DHasanboy007/Mdiplom/Welcome.md

This is your new *vault*.

Make a note of something, [[create a link]], or try [the Importer](https://help.obsidian.md/Plugins/Importer)!

When you're ready, delete this note and make the vault your own.
