DHasanboy007/Mdiplom/plata/ДИПЛОМ/report.txt

Plotted to 'C:\Users\User\Desktop\UMUMIY\ДИПЛОМ\ДИПЛОМ.pdf'.

Info: Done.
Plotted to 'C:\Users\User\Desktop\UMUMIY\ДИПЛОМ\ДИПЛОМ.pdf'.

Info: Done.
Plotted to 'C:\Users\User\Desktop\ДИПЛОМ.pdf'.

Info: Done.
Plotted to 'C:\Users\User\Desktop\ДИПЛОМ.pdf'.

Info: Done.
Info: Done.
Info: Done.
Info: Done.
Info: Done.
