DHasanboy007/Mdiplom/rasmlar/Rasmlar Anaconda/ieee_488_gpib_clean_schematic.png

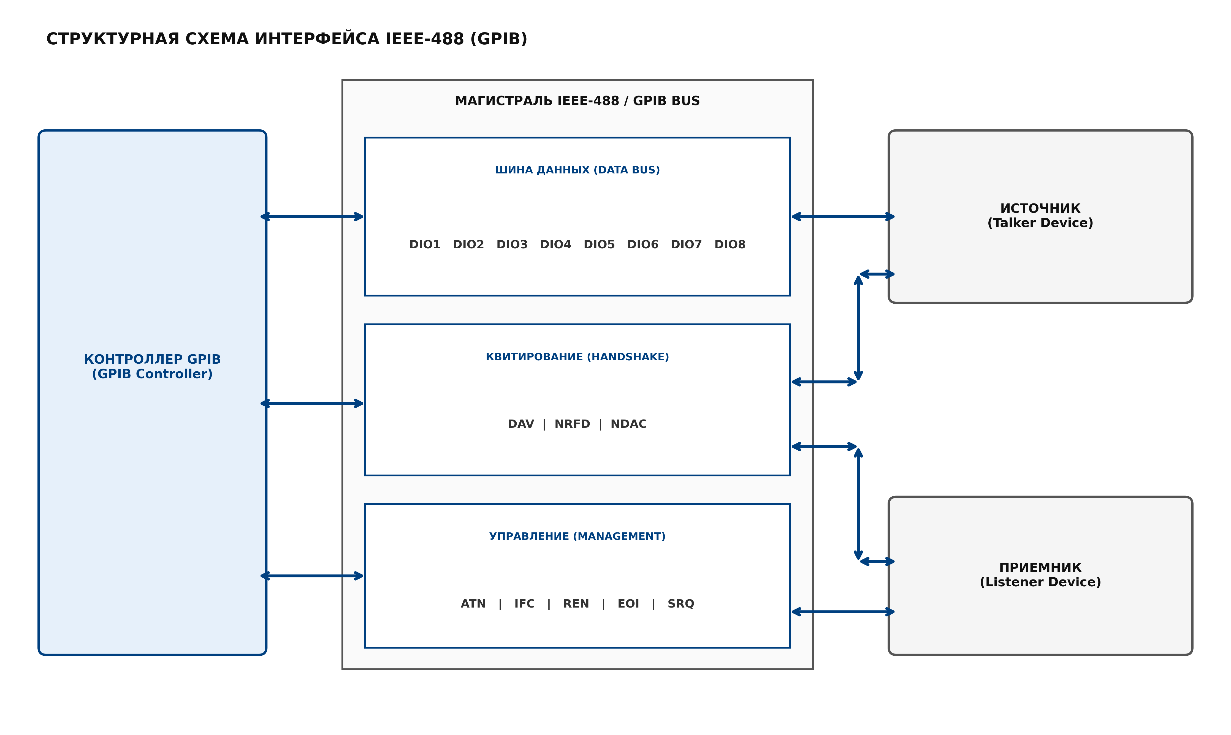
rasmlar/Rasmlar Anaconda/ieee_488_gpib_clean_schematic.png
