DHasanboy007/Mdiplom/rasmlar/Rasmlar Anaconda/ieee_488_gpib_fixed_ru.png

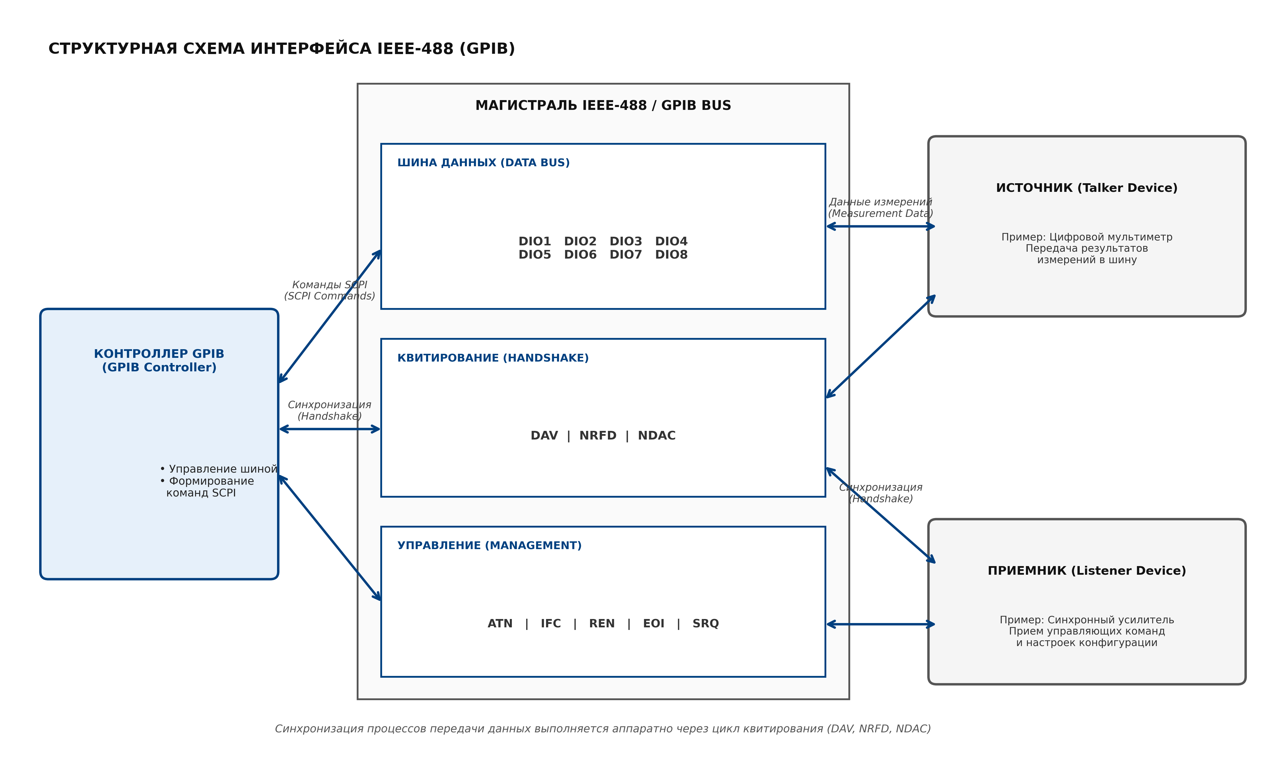
rasmlar/Rasmlar Anaconda/ieee_488_gpib_fixed_ru.png
