DHasanboy007/Mdiplom/rasmlar/Rasmlar Anaconda/ieee_488_gpib_perfect_ru.png

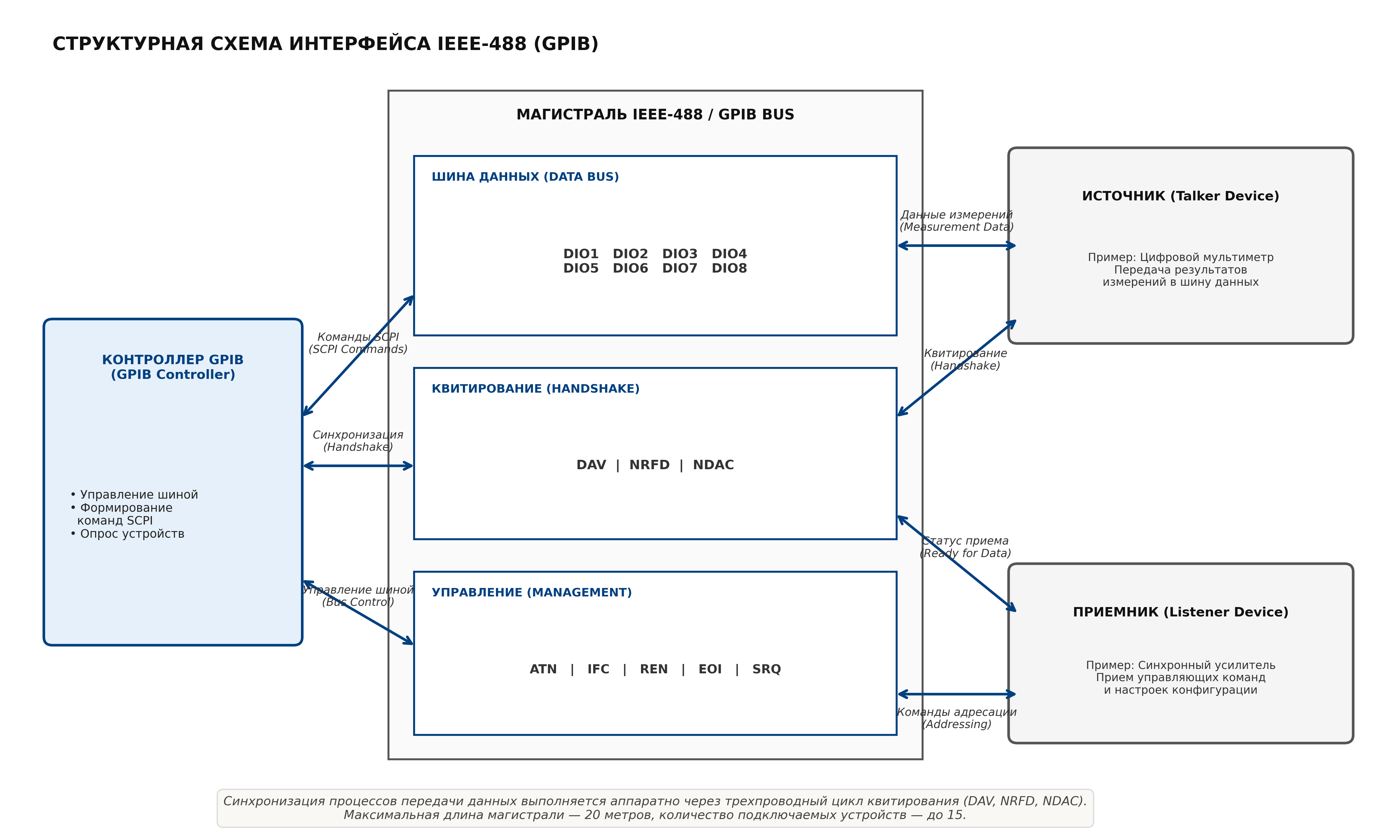
rasmlar/Rasmlar Anaconda/ieee_488_gpib_perfect_ru.png
