DHasanboy007/Mdiplom/rasmlar/Rasmlar Anaconda/structural_diagram.png

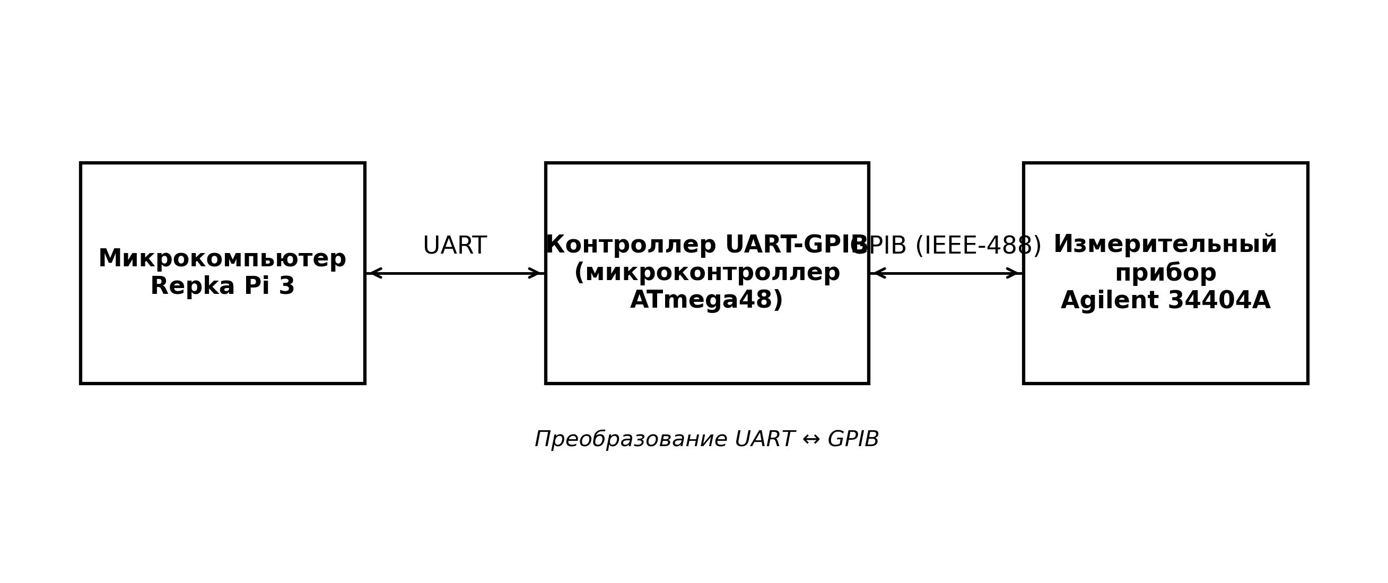
rasmlar/Rasmlar Anaconda/structural_diagram.png
