DHasanboy007/Mdiplom/plata/ДИПЛОМ/ДИПЛОМ.pdf

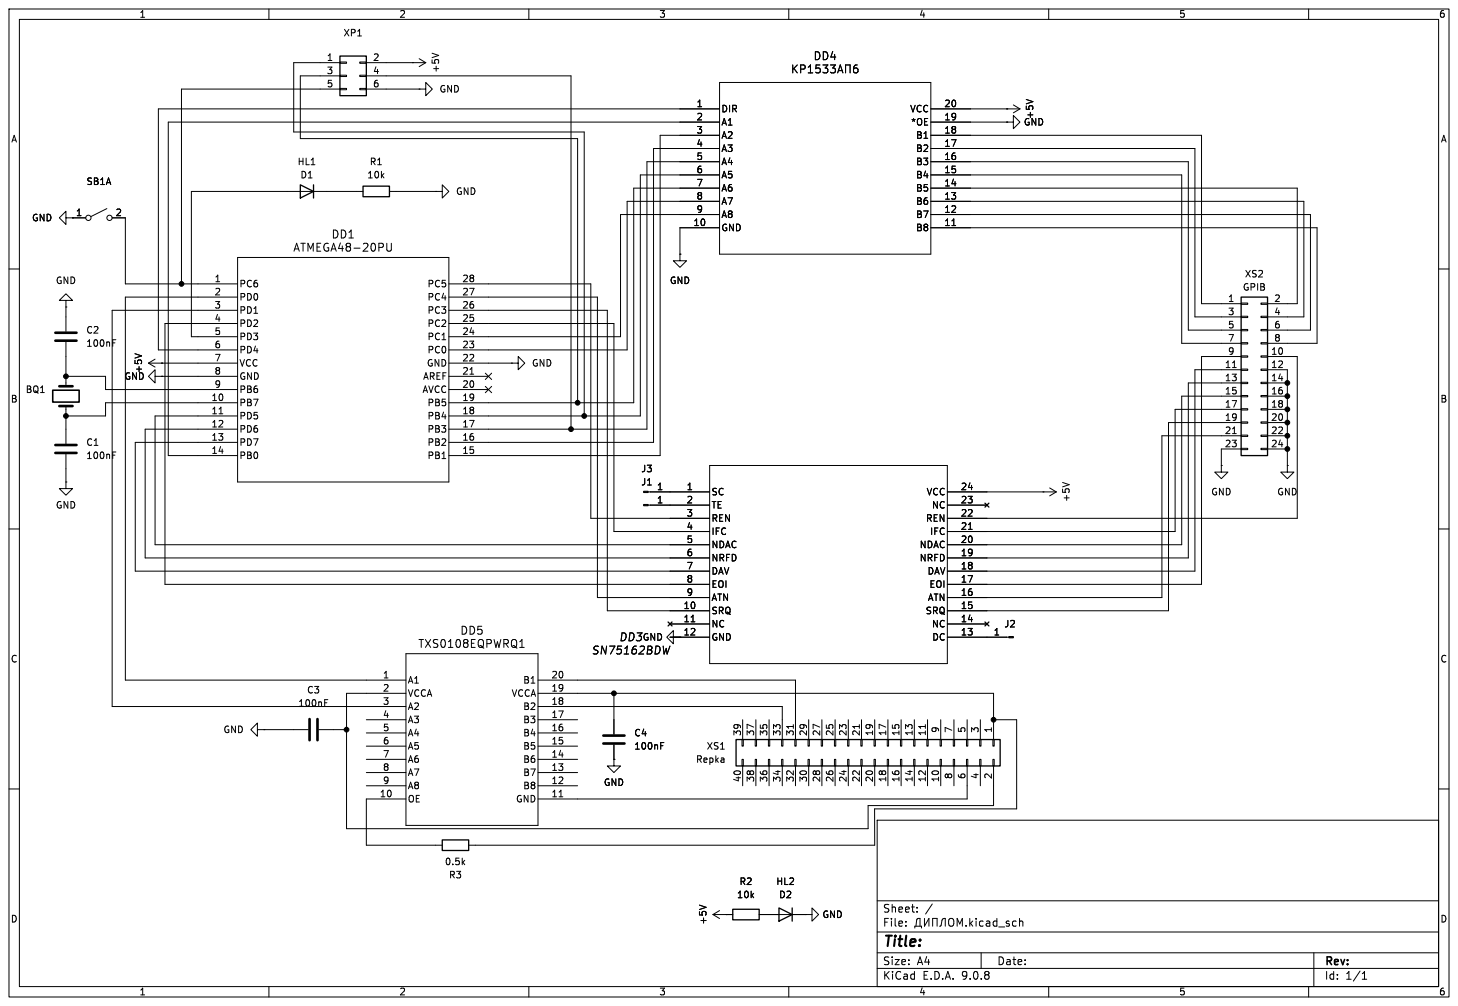
[picture p27: page 1]

Id: 1/1 Title: File: þÿ.kicad_sch Sheet: / R2
