DHasanboy007/Mdiplom/plata/ДИПЛОМ/ДИПЛОМ.kicad_pcb

## KiCad design plata/ДИПЛОМ/ДИПЛОМ.kicad_pcb (2026-06-03)

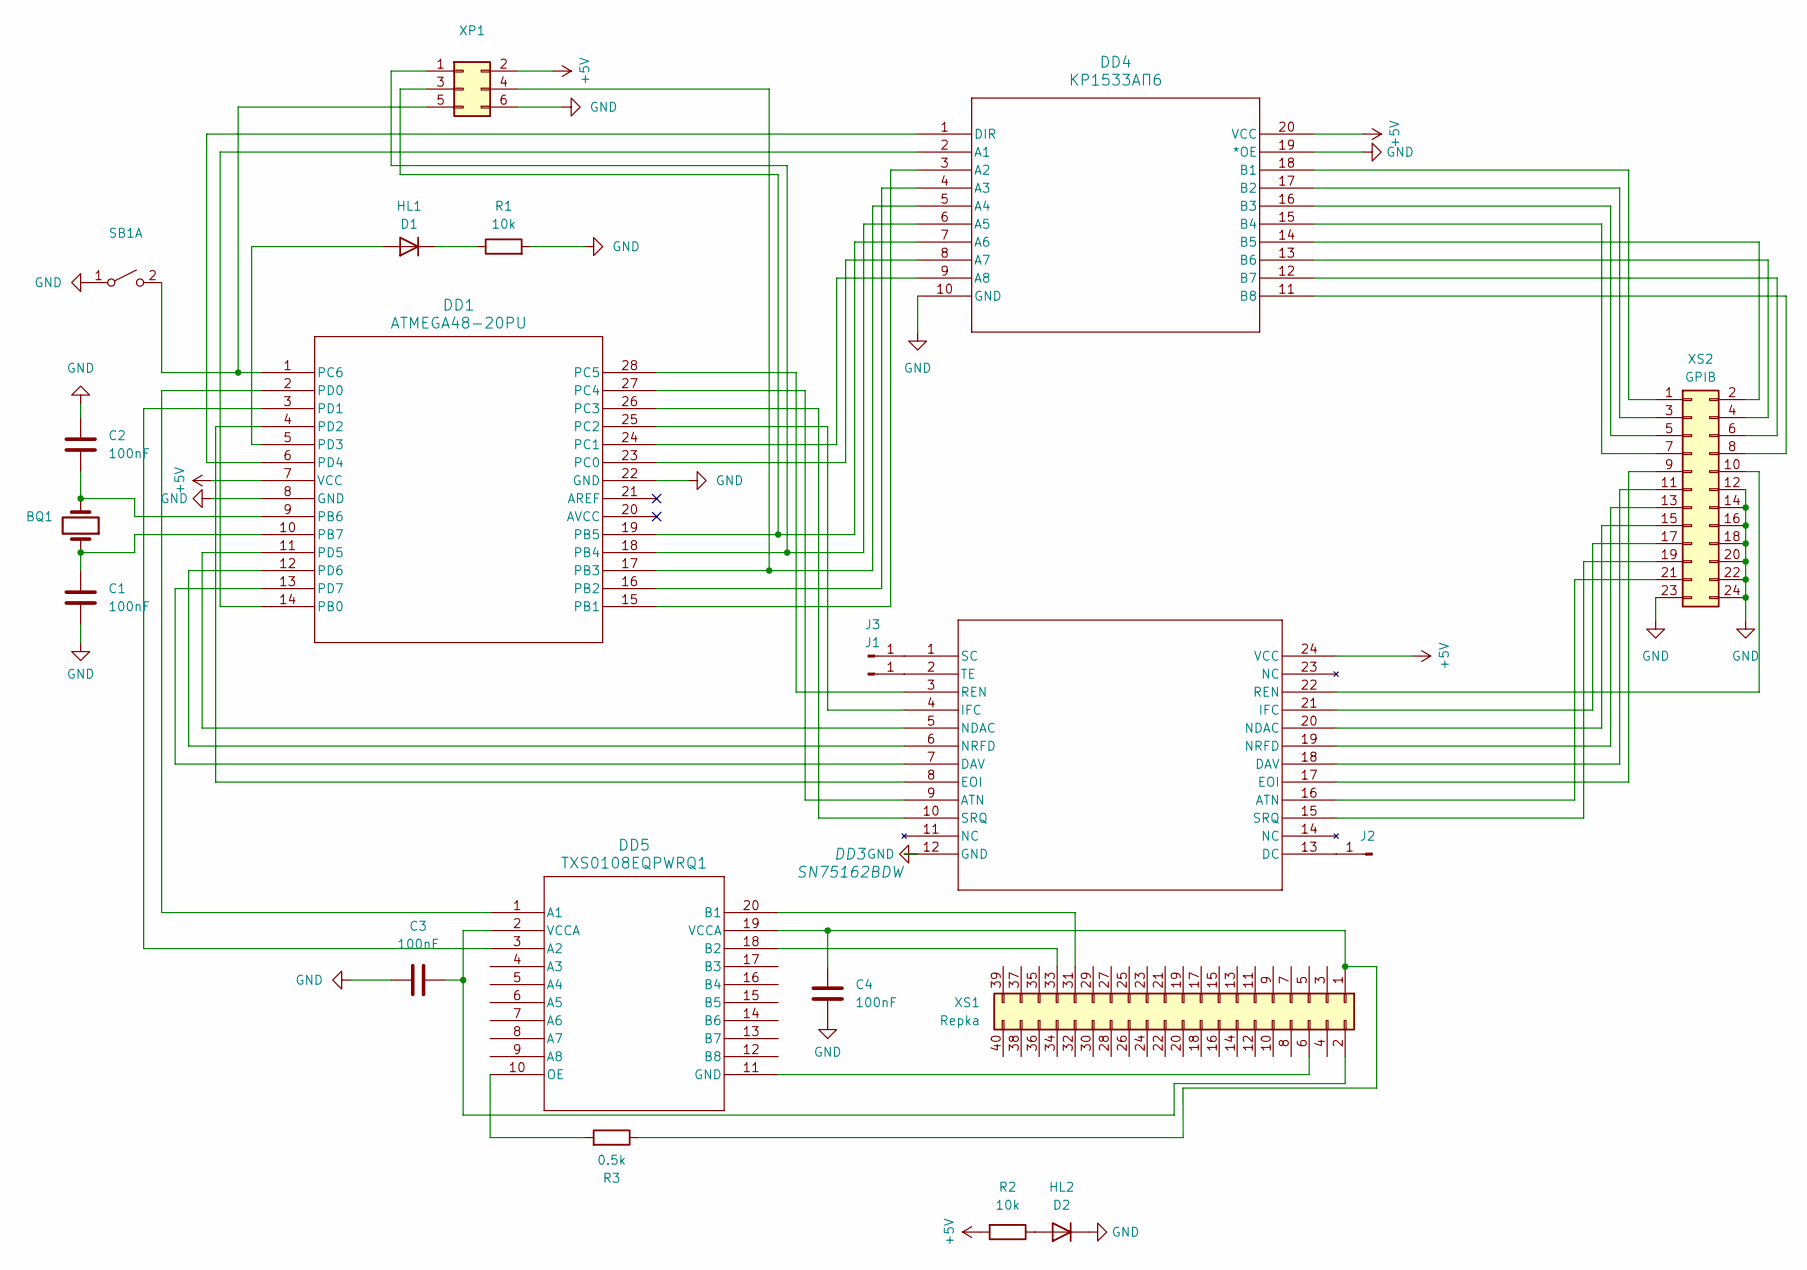
[picture p28: schematic ДИПЛОМ.kicad_sch]

Parts:
BQ1: Crystal; Crystal_HC49-U_Vertical
C1, C2, C3, C4: 100nF; C_0805_2012Metric
DD1: ATMEGA48-20PU; DIP-28_W7.62mm_SMDSocket_SmallPads
DD3: SN75162BDW; SOIC-24W_7.5x15.4mm_P1.27mm
DD4: КР1533АП6; DIP-20_W7.62mm
DD5: TXS0108EQPWRQ1; TSSOP-20_4.4x6.5mm_P0.65mm
HL1: D1; D_SOD-123
HL2: D2; D_SOD-123
J1, J2, J3: Conn_01x01_Pin; PinHeader_1x01_P2.54mm_Vertical
R1, R2: 10k; R_0805_2012Metric
R3: 0.5k; R_0805_2012Metric
SB1: SW_DPST_x2; SW_Push_1P1T_NO_E-Switch_TL3301NxxxxxG
XP1: Conn_02x03_Odd_Even; PinHeader_2x03_P2.54mm_Vertical
XS1: Repka; PinSocket_2x20_P2.54mm_Vertical
XS2: GPIB; PinSocket_2x12_P2.54mm_Vertical

Connections:
+5V: DD1.7 (VCC), DD3.24 (VCC), DD4.20 (VCC), R2.2, XP1.2
GND: C1.2, C2.1, C3.2, C4.2, DD1.8 (GND), DD1.22 (GND), DD3.12 (GND), DD4.10 (GND), DD4.19 (*OE), HL2.1 (K), R1.2, SB1.1 (A), XP1.6, XS2.12, XS2.14, XS2.16, XS2.18, XS2.20, XS2.22, XS2.23, XS2.24
unnamed: DD1.14 (PB0), DD4.2 (A1)
unnamed: DD1.15 (PB1), DD4.3 (A2)
unnamed: DD1.16 (PB2), DD4.4 (A3)
unnamed: DD1.17 (PB3), DD4.5 (A4), XP1.4
unnamed: DD1.18 (PB4), DD4.6 (A5), XP1.1
unnamed: DD1.19 (PB5), DD4.7 (A6), XP1.3
unnamed: BQ1.2, C2.2, DD1.9 (PB6)
unnamed: BQ1.1, C1.1, DD1.10 (PB7)
unnamed: DD1.23 (PC0), DD4.8 (A7)
unnamed: DD1.24 (PC1), DD4.9 (A8)
unnamed: DD1.25 (PC2), DD3.4 (IFC)
unnamed: DD1.26 (PC3), DD3.10 (SRQ)
unnamed: DD1.27 (PC4), DD3.9 (ATN)
unnamed: DD1.28 (PC5), DD3.3 (REN)
unnamed: DD1.1 (PC6), SB1.2 (B), XP1.5
unnamed: DD1.2 (PD0), DD5.1 (A1)
unnamed: DD1.3 (PD1), DD5.3 (A2)
unnamed: DD1.4 (PD2), DD3.8 (EOI)
unnamed: DD1.5 (PD3), HL1.2 (A)
unnamed: DD1.6 (PD4), DD4.1 (DIR)
unnamed: DD1.11 (PD5), DD3.5 (NDAC)
unnamed: DD1.12 (PD6), DD3.6 (NRFD)
unnamed: DD1.13 (PD7), DD3.7 (DAV)
unnamed: DD3.13 (DC), J2.1
unnamed: DD3.1 (SC), J3.1
unnamed: DD3.2 (TE), J1.1
unnamed: DD4.18 (B1), XS2.1
unnamed: DD4.17 (B2), XS2.3
unnamed: DD4.16 (B3), XS2.5
unnamed: DD4.15 (B4), XS2.7
unnamed: DD4.14 (B5), XS2.2
unnamed: DD4.13 (B6), XS2.4
unnamed: DD4.12 (B7), XS2.6
unnamed: DD4.11 (B8), XS2.8
unnamed: DD5.20 (B1), XS1.31
unnamed: DD5.18 (B2), XS1.33
unnamed: DD5.11 (GND), XS1.6
unnamed: DD5.10 (OE), R3.2
unnamed: HL1.1 (K), R1.1
unnamed: HL2.2 (A), R2.1
unnamed: C4.1, DD5.19 (VCCA), R3.1, XS1.1
unnamed: C3.1, DD5.2 (VCCA), XS1.2
unnamed: DD3.17 (EOI), XS2.9
unnamed: DD3.22 (REN), XS2.10
unnamed: DD3.18 (DAV), XS2.11
unnamed: DD3.19 (NRFD), XS2.13
unnamed: DD3.20 (NDAC), XS2.15
unnamed: DD3.21 (IFC), XS2.17
unnamed: DD3.15 (SRQ), XS2.19
unnamed: DD3.16 (ATN), XS2.21

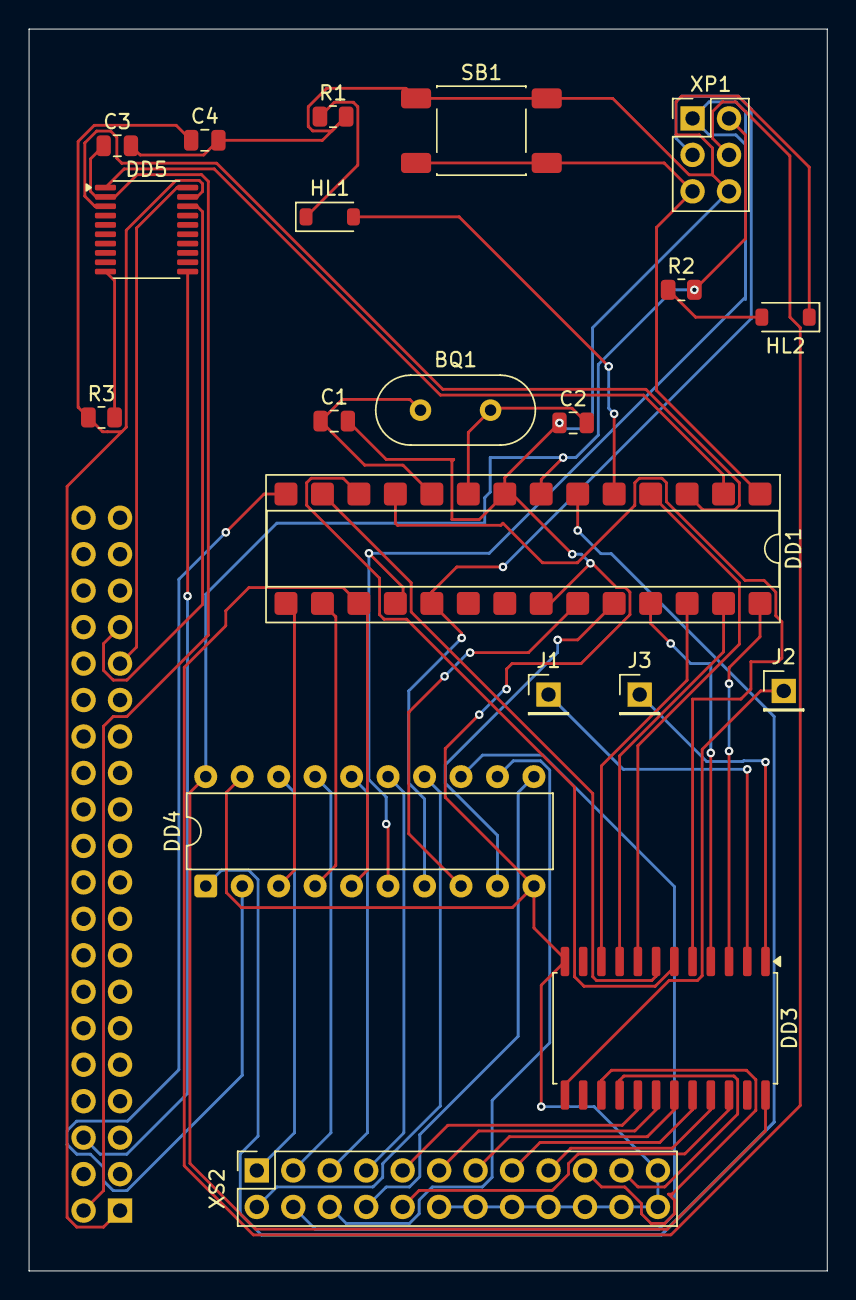
[picture p29: board ДИПЛОМ.kicad_pcb from above]

Board: 2 copper layers, 55.6 x 86.5 mm, 21 parts (1 on the bottom side), 52 nets.
